hackzone/cz18-badge/hardware/design/vector-kong/All.png

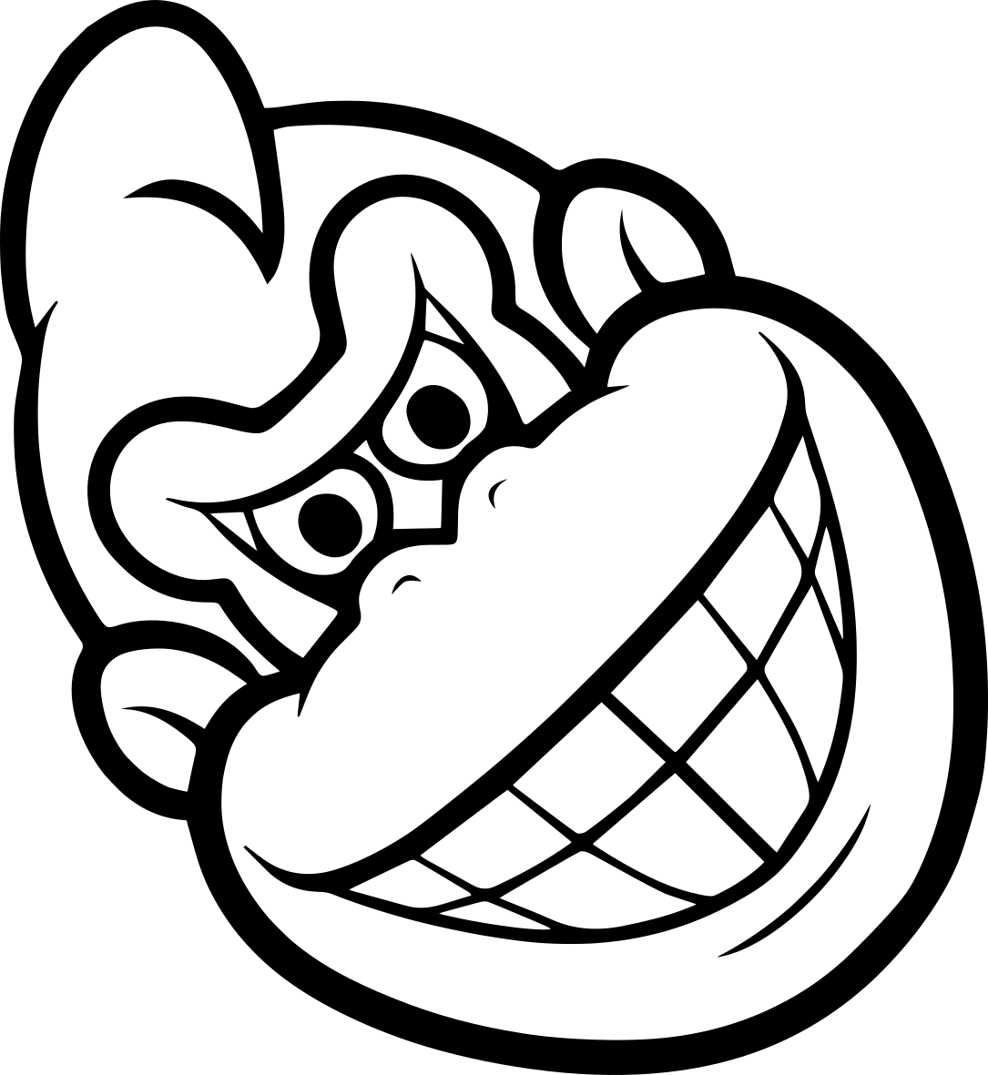
hardware/design/vector-kong/All.png
