hackzone/cz18-badge/hardware/design/vector-kong/Back Fill.png

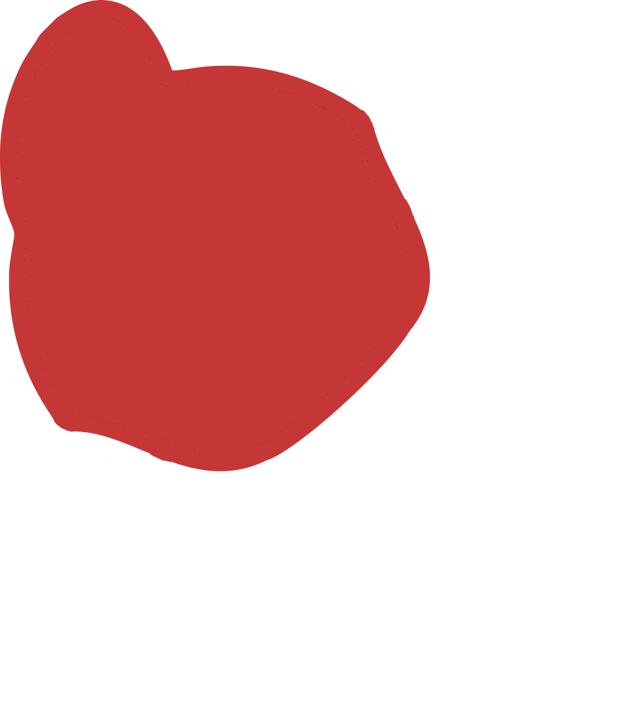
hardware/design/vector-kong/Back Fill.png
