hackzone/cz18-badge/hardware/design/vector-kong/Back Outline.png

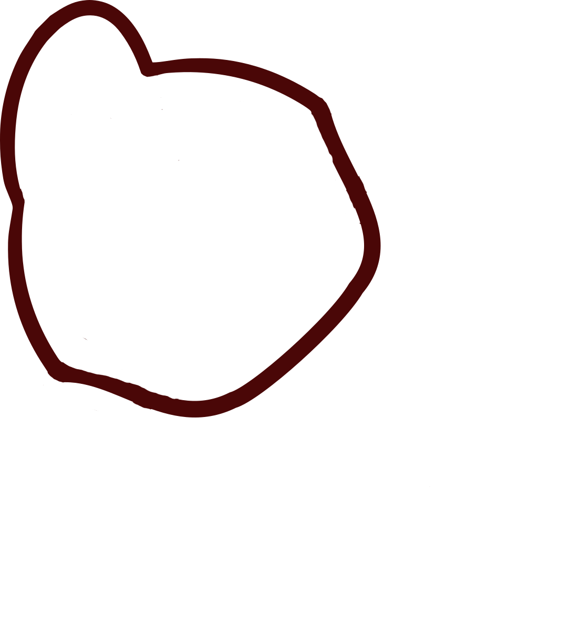
hardware/design/vector-kong/Back Outline.png
