hackzone/cz18-badge/hardware/design/vector-kong/Back.png

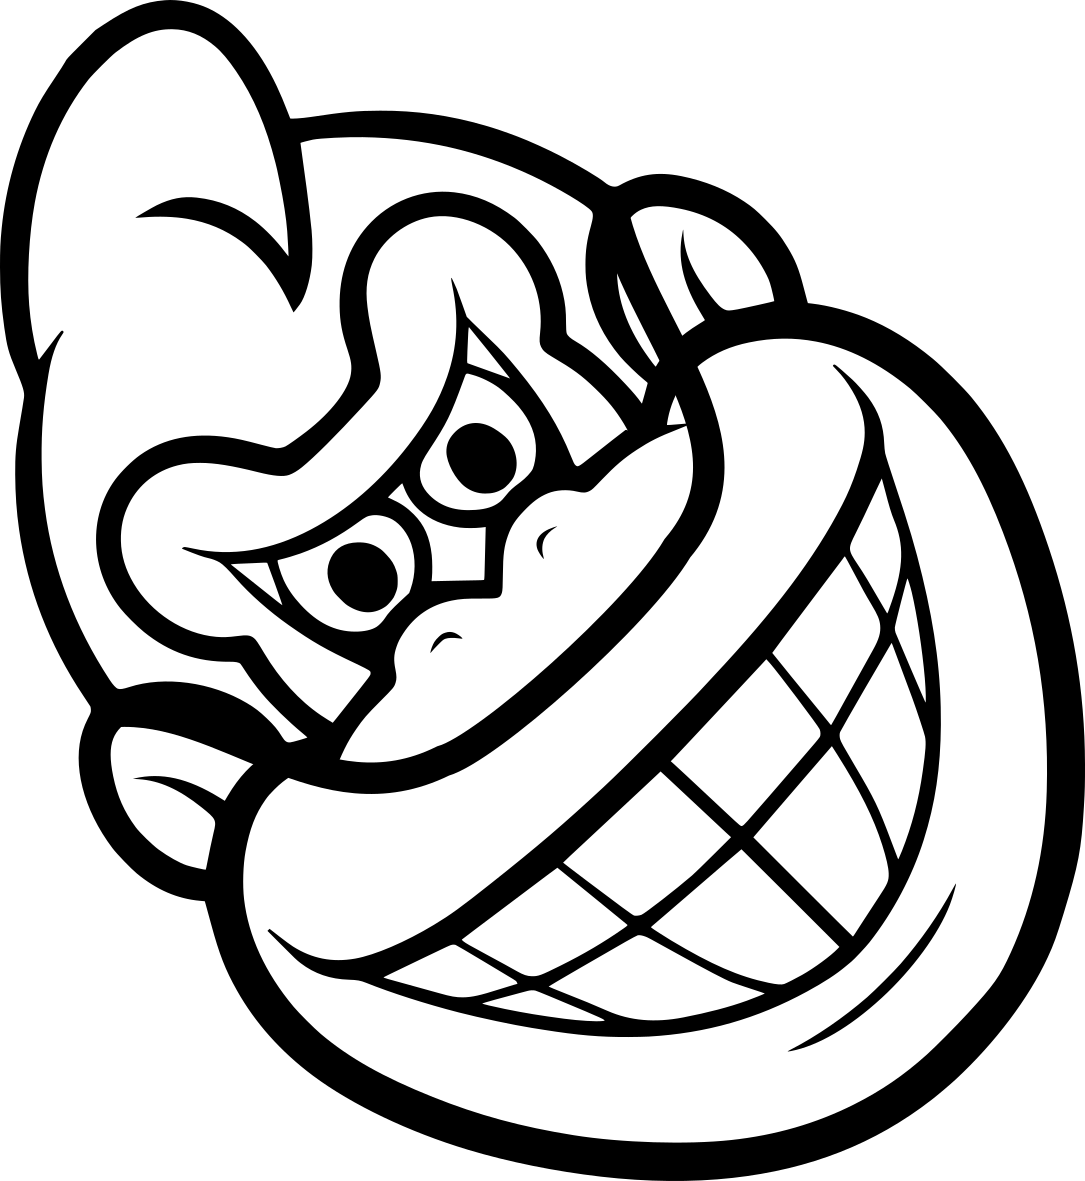
hardware/design/vector-kong/Back.png
