hackzone/cz18-badge/hardware/design/vector-kong/Copper.bmp

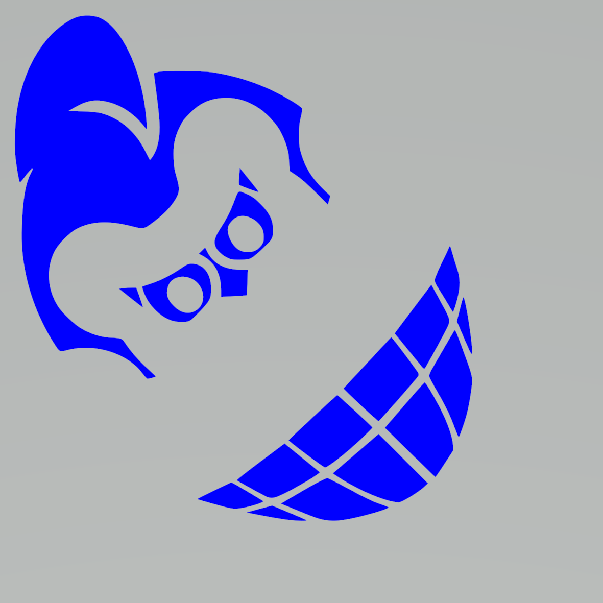
hardware/design/vector-kong/Copper.bmp
