hackzone/cz18-badge/hardware/design/vector-kong/Original Outline.jpg

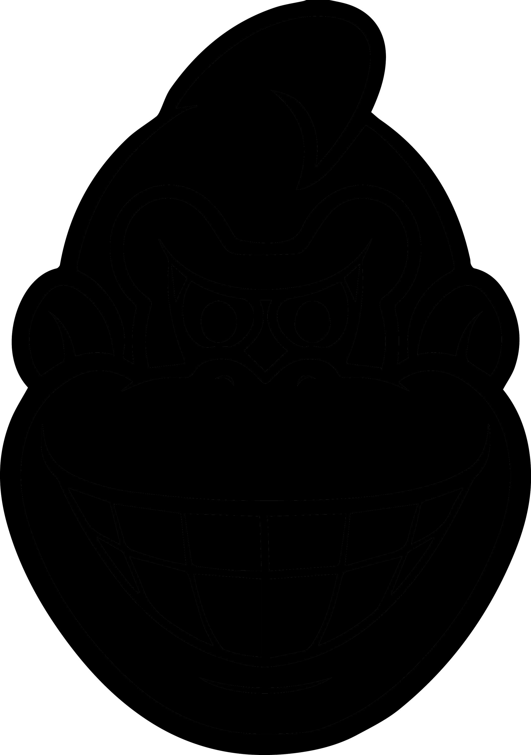
hardware/design/vector-kong/Original Outline.jpg
