hackzone/cz18-badge/hardware/design/vector-kong/Original.jpg

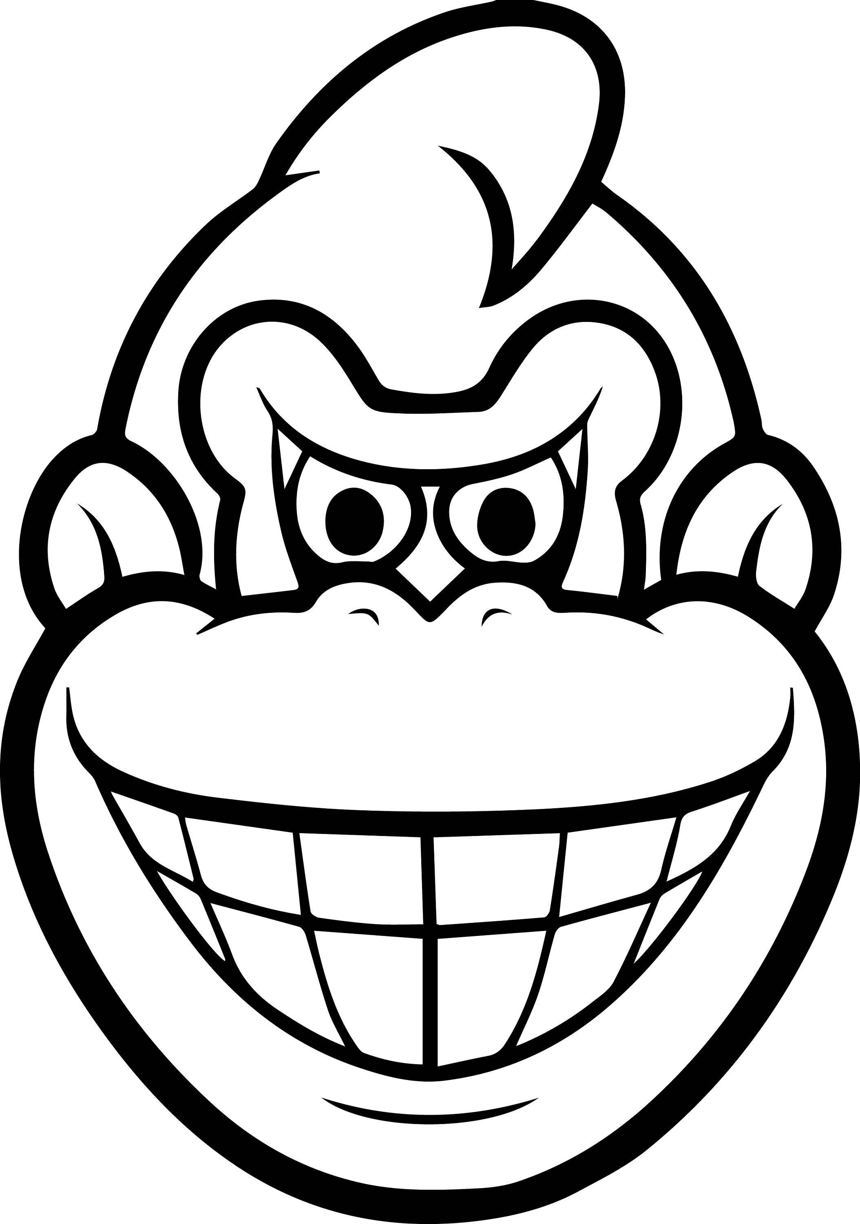
hardware/design/vector-kong/Original.jpg
