hackzone/cz18-badge/hardware/design/vector-kong/Silkscreen.bmp

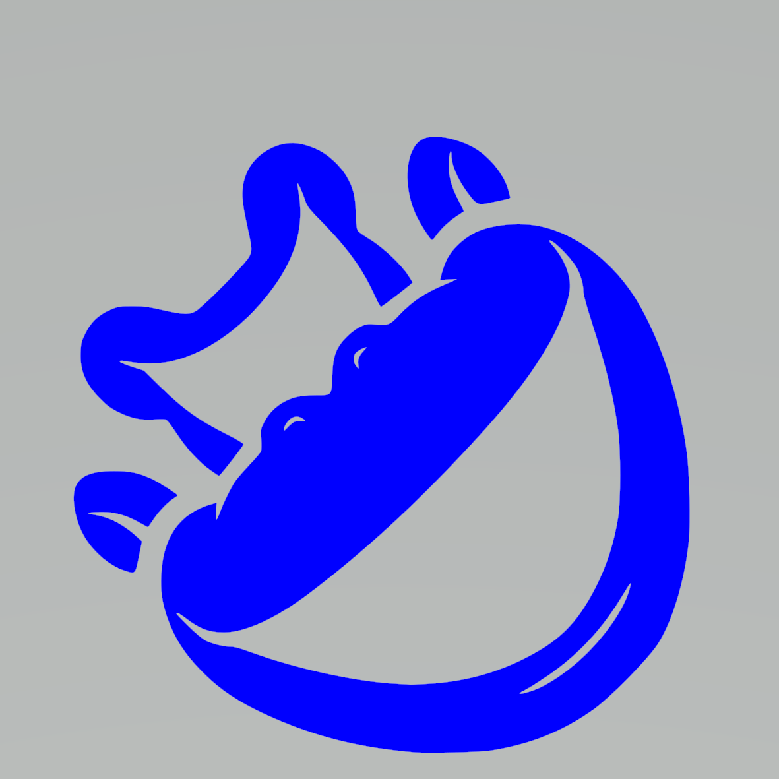
hardware/design/vector-kong/Silkscreen.bmp
