hackzone/cz18-badge/hardware/design/vector-kong/Tin.bmp

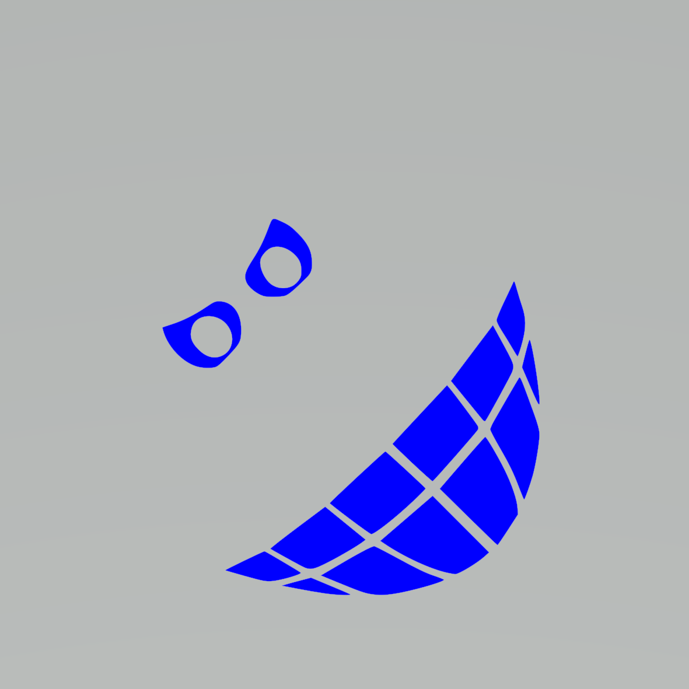
hardware/design/vector-kong/Tin.bmp
