hackzone/cz18-badge/hardware/design/vector-kong/Back Copper.dxf

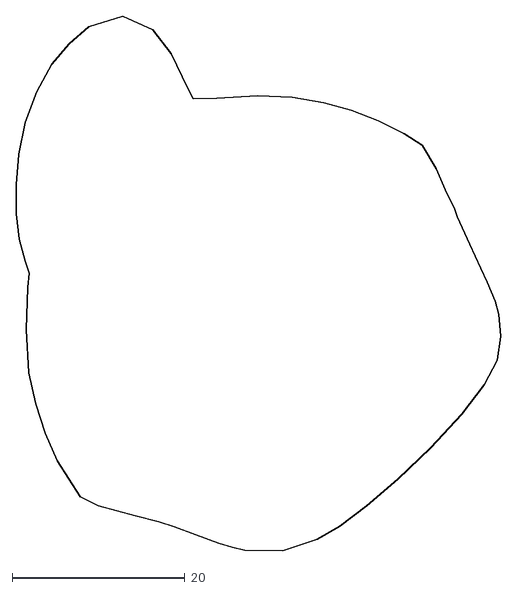
[picture p10: CAD file, 2018-06-12]
hardware/design/vector-kong/Back Copper.dxf
56.0 x 61.8
