hackzone/cz18-badge/hardware/design/vector-kong/Back Soldermask.dxf

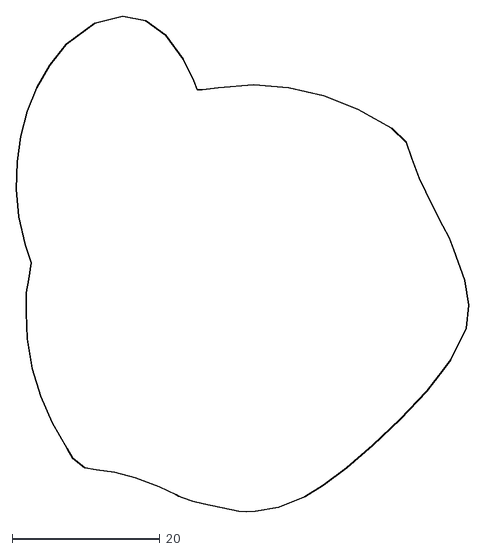
[picture p11: CAD file, 2018-06-12]
hardware/design/vector-kong/Back Soldermask.dxf
61.2 x 67.1
