hackzone/cz18-badge/hardware/design/vector-kong/Copper Edges.dxf

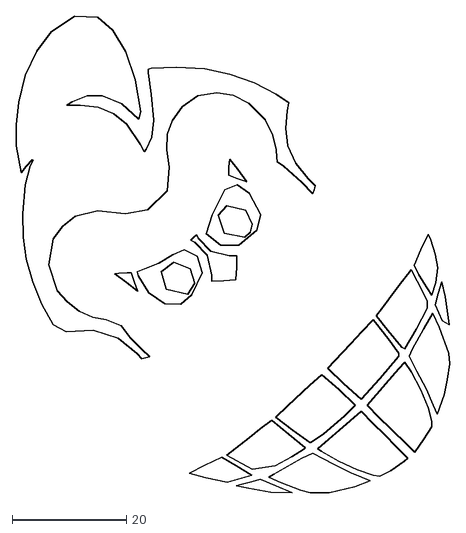
[picture p12: CAD file, 2018-06-11]
hardware/design/vector-kong/Copper Edges.dxf
75.7 x 83.4
