hackzone/cz18-badge/hardware/design/vector-kong/Outline.dxf

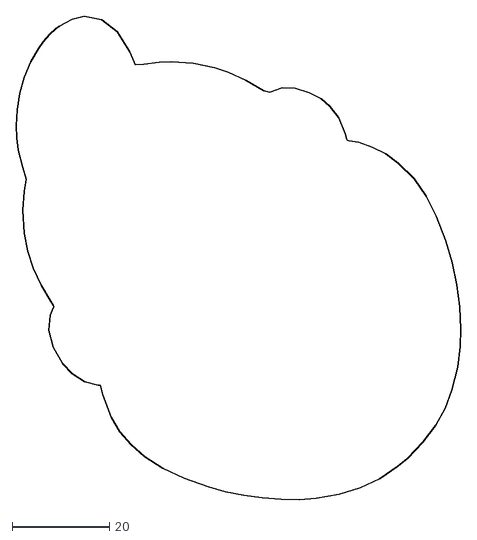
[picture p13: CAD file, 2018-06-10]
hardware/design/vector-kong/Outline.dxf
91.5 x 99.6
