hackzone/cz18-badge/hardware/design/vector-kong/Soldermask.png

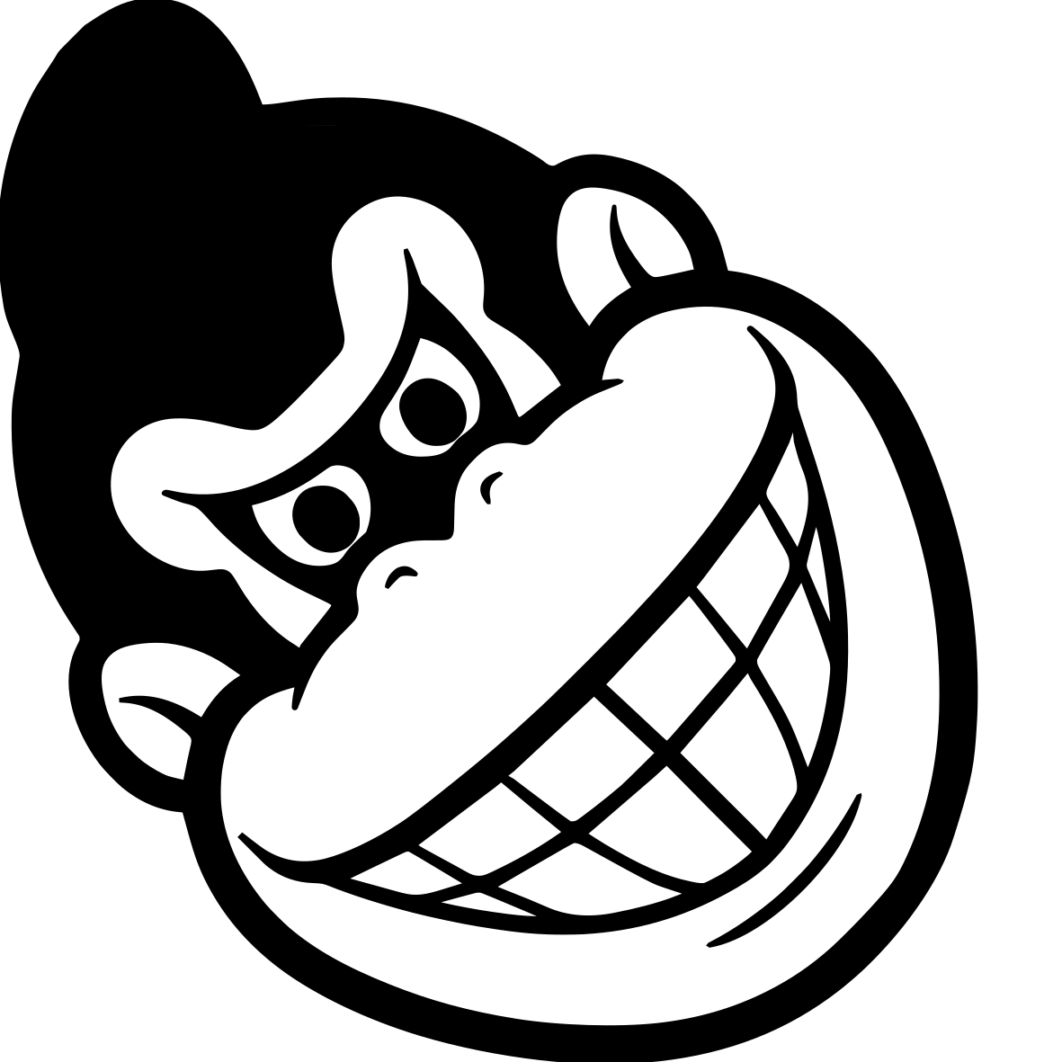
hardware/design/vector-kong/Soldermask.png
