hackzone/cz18-badge/hardware/front.pdf

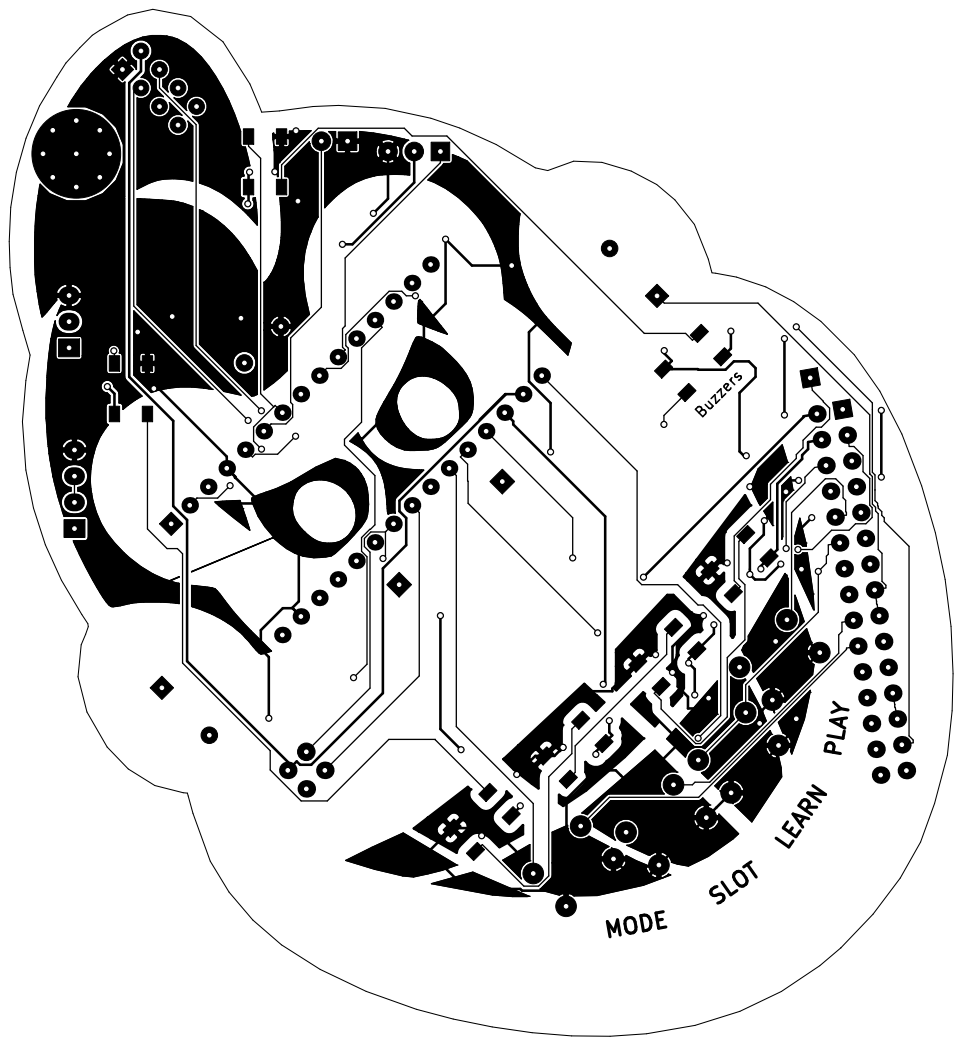
[picture p19: page 1]

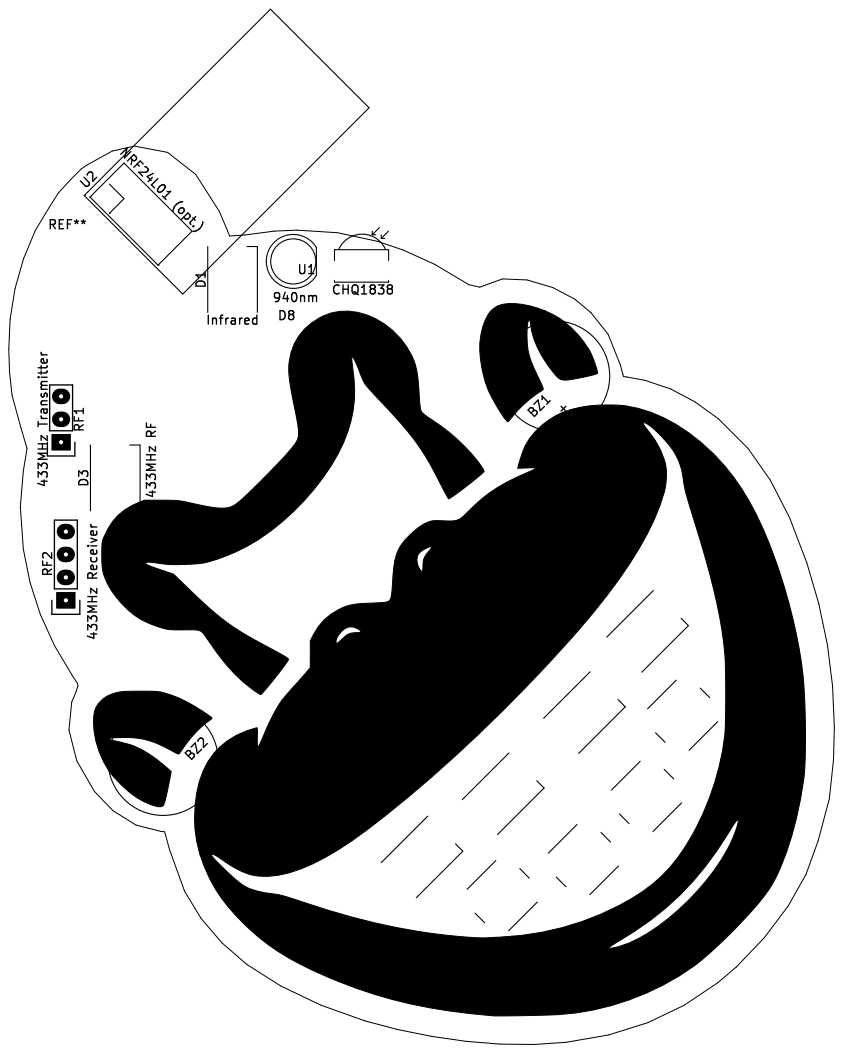
[picture p20: page 2]

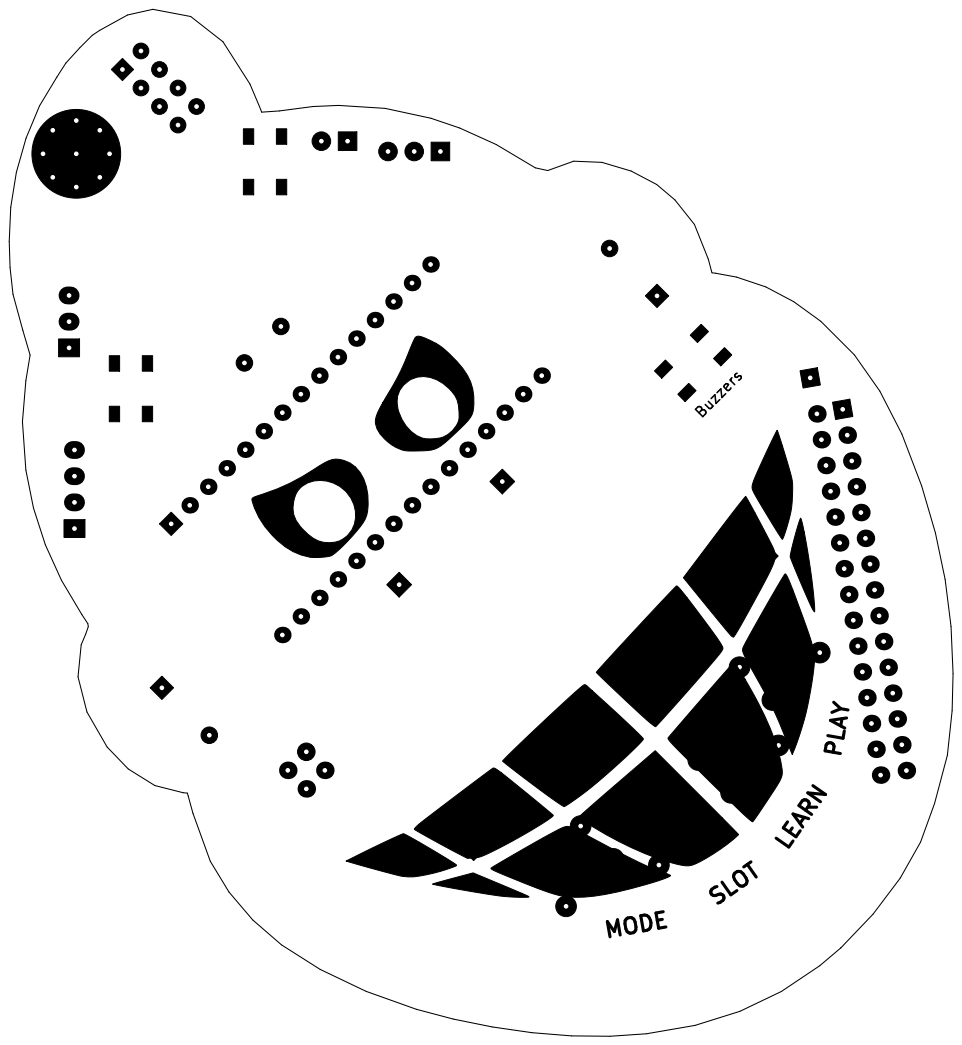
[picture p21: page 3]
