hackzone/cz18-badge/(list of files, drawings)

Other design files:
hardware/cz18_badge.dsn
