hackzone/cz18-badge/hardware/cz18_badge.kicad_pcb

## KiCad design hardware/cz18_badge.kicad_pcb (2018-07-03)

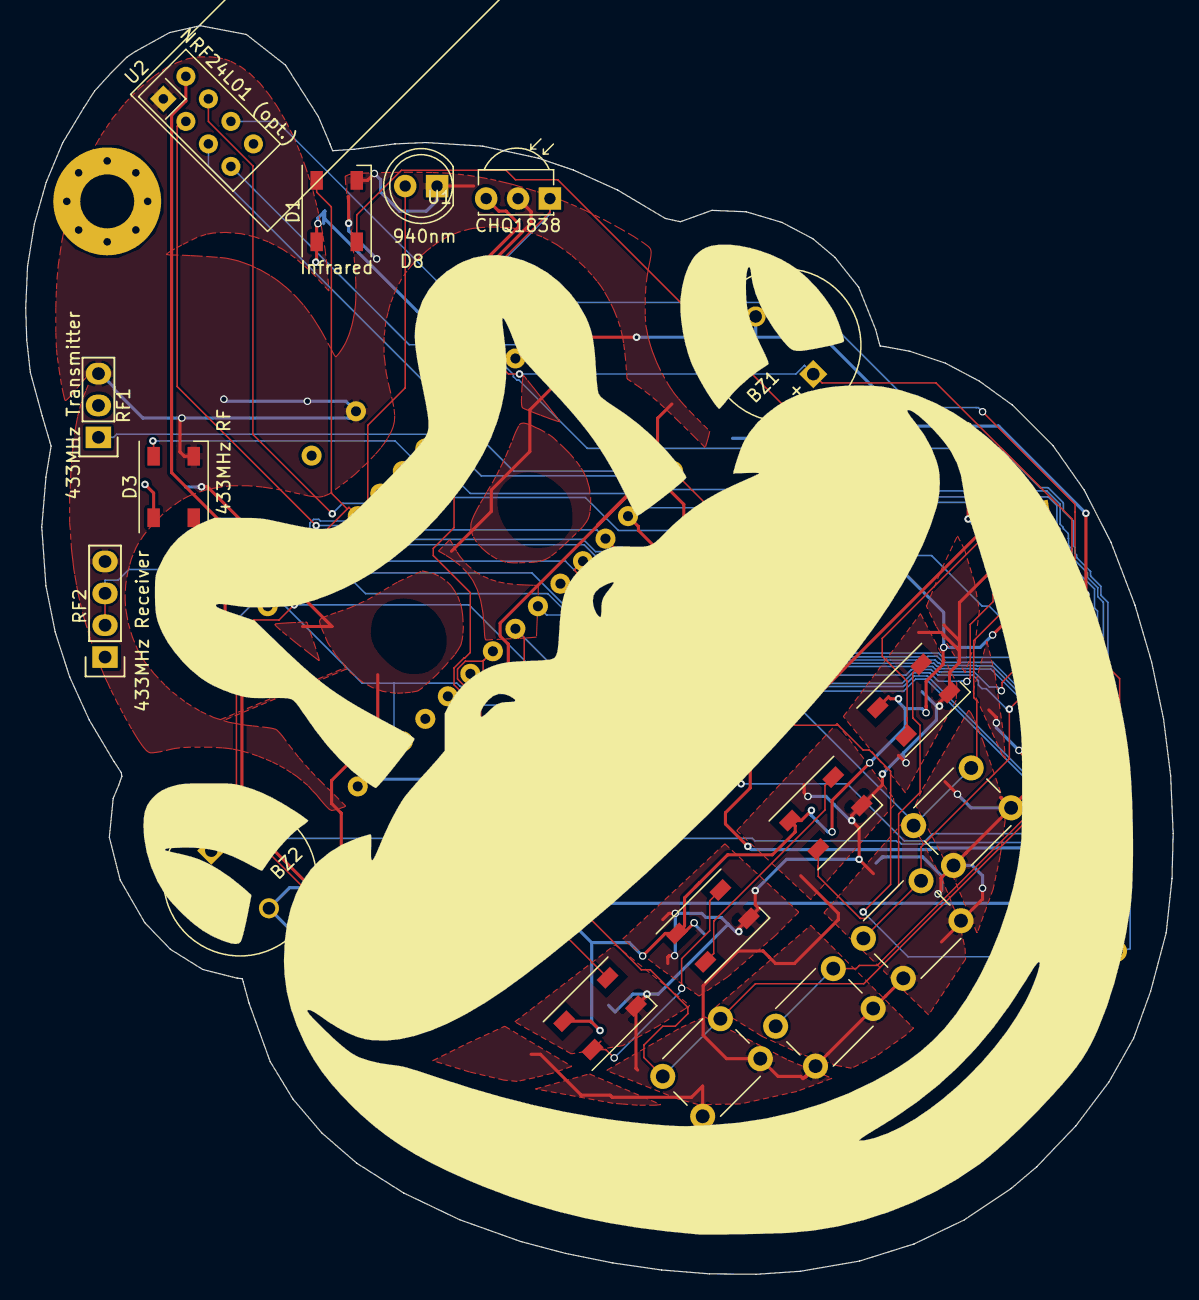
[picture p22: board cz18_badge.kicad_pcb from above]

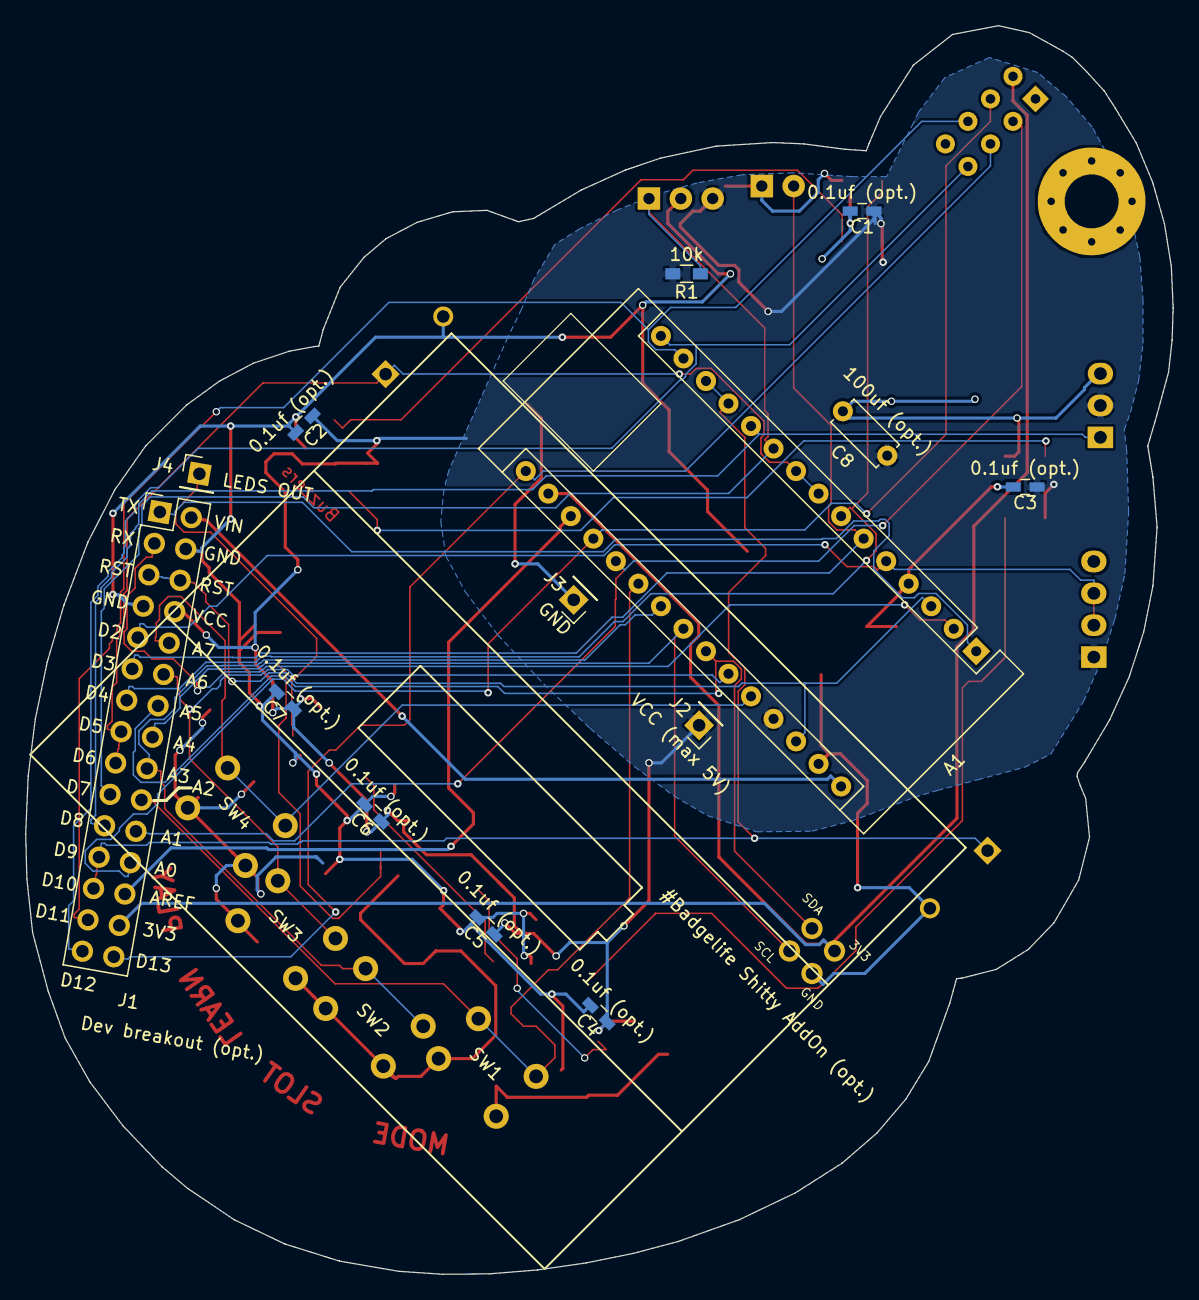
[picture p23: board cz18_badge.kicad_pcb from below]

Board: 2 copper layers, 91.5 x 99.6 mm, 36 parts (14 on the bottom side), 33 nets.

Parts:
A1: Arduino Nano v3.x; Arduino_Nano
BATT: AA Battery holder silkscreen; AA_Battery_holder_silkscreen
BZ1, BZ2: Buzzer; MagneticBuzzer_ProSignal_ABT-410-RC
C1, C2, C3, C4, C5, C6, C7: 0.1uf (opt.); C_0603_HandSoldering
C8: 100uf (opt.); C_Disc_D5.0mm_W2.5mm_P5.00mm
D1: Infrared; LED_SK6812_PLCC4_5.0x5.0mm_P3.2mm
D2, D4, D5, D6, D7: SK6812; LED_SK6812_PLCC4_5.0x5.0mm_P3.2mm
D3: 433MHz RF; LED_SK6812_PLCC4_5.0x5.0mm_P3.2mm
D8: 940nm; LED_D5.0mm
J1: Dev breakout (opt.); Pin_Header_Straight_2x15_Pitch2.54mm
J2: VCC (max 5V); Pin_Header_Straight_1x01_Pitch2.54mm
J3: GND; Pin_Header_Straight_1x01_Pitch2.54mm
J4: LEDS OUT; Pin_Header_Straight_1x01_Pitch2.54mm
R1: 10k; R_0603_HandSoldering
RF1: 433MHz Transmitter; RF_Transmitter_433_MHz
RF2: 433MHz Receiver; RF_Receiver_433_MHz
SILK: LOGO; Silkscreen
SW1: MODE; SW_PUSH_6mm_h4.3mm
SW2: SLOT; SW_PUSH_6mm_h4.3mm
SW3: LEARN; SW_PUSH_6mm_h4.3mm
SW4: PLAY; SW_PUSH_6mm_h4.3mm
TIN: LOGO; Tin
U1: CHQ1838; IRReceiver_Vishay_MOLD-3pin
U2: NRF24L01 (opt.); nRF24L01_Breakout
X1: #Badgelife Shitty AddOn (opt.); Badgelife-Shitty-2x2

Connections:
3V3: A1.17, J1.28, U2.2, X1.1
A0: A1.19, J1.24, U2.4
A1: A1.20, J1.22, U2.3
A2: A1.21, J1.20, SW1.1
A3: A1.22, J1.18, SW2.1
A4: A1.23, J1.16, X1.3
A5: A1.24, J1.14, X1.4
A6: A1.25, J1.12, SW3.1
A7: A1.26, J1.10, SW4.1
AREF: A1.18, J1.26
BUZZ1: A1.8, A1.9, BZ1.1, J1.15, J1.17
BUZZ2: A1.12, A1.13, BZ2.1, J1.23, J1.25
D2: A1.5, J1.9, RF2.2, RF2.3
D3: A1.6, D8.2, J1.11
D4: A1.7, D1.2, J1.13
D7: A1.10, J1.19, R1.1, U1.1
D8: A1.11, J1.21, RF1.1
D11: A1.14, J1.27, U2.6
D12: A1.15, J1.29, U2.7
D13: A1.16, J1.30, U2.5
GND: A1.4, A1.29, BZ1.2, BZ2.2, C1.2, C2.2, C3.2, C4.2, C5.2, C6.2, C7.2, C8.2, D1.1, D2.1, D3.1, D4.1, D5.1, D6.1, D7.1, D8.1, J1.4, J1.7, J3.1, RF1.3, RF2.4, SW1.2, SW2.2, SW3.2, SW4.2, U1.2, U2.1, X1.2
unnamed: D1.4, D2.2
unnamed: D2.4, D3.2
unnamed: D3.4, D4.2
unnamed: D4.4, D5.2
unnamed: D5.4, D6.2
unnamed: D6.4, D7.2
unnamed: D7.4, J4.1
RESET: A1.3, A1.28, J1.5, J1.6
RX: A1.2, J1.3
TX: A1.1, J1.1
VCC: A1.27, C1.1, C2.1, C3.1, C4.1, C5.1, C6.1, C7.1, C8.1, D1.3, D2.3, D3.3, D4.3, D5.3, D6.3, D7.3, J1.8, J2.1, R1.2, RF1.2, RF2.1, U1.3
VIN: A1.30, J1.2
