hackzone/cz18-badge/firmware/cybers.h

//
// Created by Tom on 29/07/2018.
//

#ifndef FIRMWARE_CYBERS_H
#define FIRMWARE_CYBERS_H

#include "common.h"

void cybest(const char *text);
void cybercyber(void (*prnt)(const char *));
volatile void cybercybercyber(char* stuff);
volatile void cybercybercyber(char* stuff);
volatile void cybarsinthecybe(char* stuff);
volatile void cybesinthecybar(char* stuff);
volatile void cybesinthecyber(char* stuff1, char* stuff2);

#endif //FIRMWARE_CYBERS_H
