hackzone/cz18-badge/(commit log)

2018-05-21 Initial fill w/ portion of components populated
    [cz18_badge.kicad_pcb, cz18_badge.sch]
2018-05-21 Added todo comments
    [cz18_badge.kicad_pcb, cz18_badge.sch]
2018-06-03 Combined hardware and firmware into one repo
    [cz18_badge.kicad_pcb, cz18_badge.sch]
2018-06-03 Added 433MHz modules
    [cz18_badge.kicad_pcb, cz18_badge.sch]
2018-06-04 Connected component labels
    [cz18_badge.dsn, cz18_badge.kicad_pcb, cz18_badge.sch]
2018-06-04 Added battery and dev breakout, routed dev traces on test PCB
    [cz18_badge.dsn, cz18_badge.kicad_pcb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]
2018-06-04 Updated test PCB (single layer)
    [cz18_badge.dsn, cz18_badge.kicad_pcb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]
2018-06-10 Added buttons and 2 additional LEDs
    [cz18_badge.sch]
2018-06-10 Added vector-kong drawings
    [Outline.dxf]
2018-06-10 Implemented vectorised kong. All works, but no clearance between traces and areas. Will add manual fill zones.
    [cz18_badge-B.Cu.gbr, cz18_badge-B.Mask.gbr, cz18_badge-B.Paste.gbr, cz18_badge-B.SilkS.gbr, cz18_badge-Edge.Cuts.gbr, cz18_badge-F.Mask.gbr, cz18_badge-F.Paste.gbr, cz18_badge-F.SilkS.gbr]
2018-06-11 Added AA battery holder mod fiel to vector-kong directory
    [cz18_badge-Dwgs.User.gbr]
2018-06-11 Added preliminary gerbers
    [cz18_badge.GBL, cz18_badge.GBO, cz18_badge.GBS, cz18_badge.GKO, cz18_badge.GTL, cz18_badge.GTO, cz18_badge.GTS, cz18_badge.XLN]
2018-06-11 Added Copper Eges svd and dxf.
    [Copper Edges.dxf]
2018-06-11 Moved battery holder file, added Defcon Shitty AddOn files
2018-06-11 Added Defcon Shitty AddOn footprint to pcb
    [cz18_badge.sch]
2018-06-11 Improved PCB annotation, working on manual fill zone colouring
    [cz18_badge-B.Paste.gbr, cz18_badge-F.Paste.gbr, cz18_badge.GBL, cz18_badge.GBO, cz18_badge.GBS, cz18_badge.GKO, cz18_badge.GTL, cz18_badge.GTO]
2018-06-12 Minor fixes
    [cz18_badge-B.Paste.gbr, cz18_badge-F.Paste.gbr, cz18_badge.GBL, cz18_badge.GBO, cz18_badge.GBS, cz18_badge.GKO, cz18_badge.GTL, cz18_badge.GTO]
2018-06-12 Added SVG and DXF files for the back hair.
    [Back Copper.dxf, Back Soldermask.dxf]
2018-06-14 Added lanyard hole, annotated dev headers, moved components
    [cz18_badge-B.Paste.gbr, cz18_badge-F.Paste.gbr, cz18_badge.GBL, cz18_badge.GBO, cz18_badge.GBS, cz18_badge.GKO, cz18_badge.GTL, cz18_badge.GTO]
2018-06-15 Finished annotation
    [cz18_badge.kicad_pcb]
2018-06-15 Added minimal track widths and clearances for JLCPCB
    [cz18_badge.kicad_pcb]
2018-06-15 Performed Autoroute, still 14 connections missing.
    [cz18_badge.dsn, cz18_badge.kicad_pcb]
2018-06-15 Completed final manual routing
    [cz18_badge.kicad_pcb]
2018-06-15 Added eye shade fill zones again, and performed final modifications to tracks. Generated gerber files.
    [cz18_badge-B.Paste.gbr, cz18_badge-F.Paste.gbr, cz18_badge.GBL, cz18_badge.GBO, cz18_badge.GBS, cz18_badge.GKO, cz18_badge.GTL, cz18_badge.GTO]
2018-06-15 PDFs of board layout
2018-06-17 Include the pin layout according to the wiring schematics
2018-06-17 Boilerplate for button debouncing and processing. Move the previous version into firmware.ino.old
2018-06-17 Tweak the debouncing interval and refactor button reading
2018-06-17 Swapped buttons to GND so we can use built-in atmega pullup resistors
    [cz18_badge-B.Paste.gbr, cz18_badge-F.Paste.gbr, cz18_badge.GBL, cz18_badge.GBO, cz18_badge.GBS, cz18_badge.GKO, cz18_badge.GTL, cz18_badge.GTO]
2018-06-17 Correct pin layout
2018-06-25 Refactor the button handling logic into a separate class
2018-07-03 Fixed IR receiver pinout not matching CHQ1838
    [cz18_badge-B.Paste.gbr, cz18_badge-F.Paste.gbr, cz18_badge.GBL, cz18_badge.GBO, cz18_badge.GBS, cz18_badge.GKO, cz18_badge.GTL, cz18_badge.GTO]
2018-07-14 Cleaned up & implemented mode and slot selection. Buttons don't seem functional yet on this branch
2018-07-15 Fixed the issue with jittering and unstable buttons
    [buttons.cpp, buttons.h, firmware.ino]
2018-07-15 fixed switches, added RFModule code
    [buttons.cpp, firmware.ino, rfmodule.cpp]
2018-07-15 Initial work on the IR learn and play and EEPROM rework
    [common.h, eeprom.cpp, eeprom.h, firmware.ino, ir_protocols.h]
2018-07-15 IR learn and play and eeprom fixes
    [common.h, eeprom.cpp, firmware.ino]
2018-07-15 Fix the IR learn and play
    [firmware.ino]
2018-07-16 Add heurestic for determining whether the buttons on A6 and A7 are pressed
2018-07-22 Revert "recommit"
    This reverts commit 5d168a69e120a2ad2721263858ad8e2cba4bb2e5.
    [firmware.ino]
2018-07-22 Refactor the button handling classes and remove unnecessary fields
2018-07-22 Rework learn and play for IR so that the UI is clearer
    [firmware.ino]
2018-07-22 Utilize IR slot only when it is used and add more delay to the `analogRead` switching
2018-07-30 Fixed learning and playing targeting the wrong modules
    [firmware.ino]
2018-07-30 Do not attempt to use an RF slot if it was not already set to used
2018-08-03 Fixed left speaker output
    [sound.cpp]
